kvc0/nomad3_mods/cad/bed_model.step

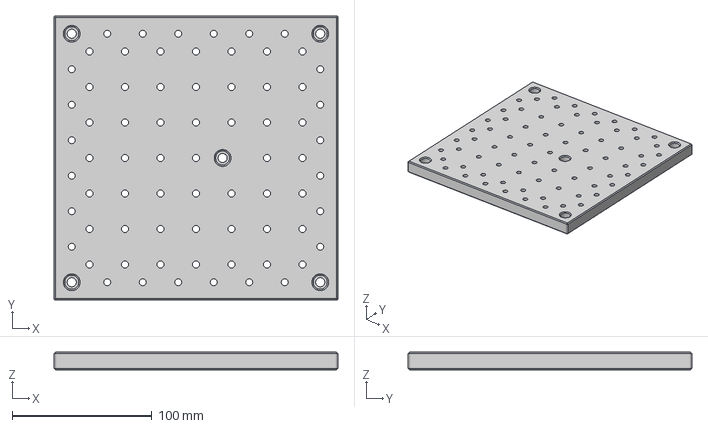
[picture p4: CAD file, 2021-01-08]
cad/bed_model.step
203.2 x 203.2 x 12.7 mm
