kvc0/nomad3_mods/models/air_blast_lock.stl

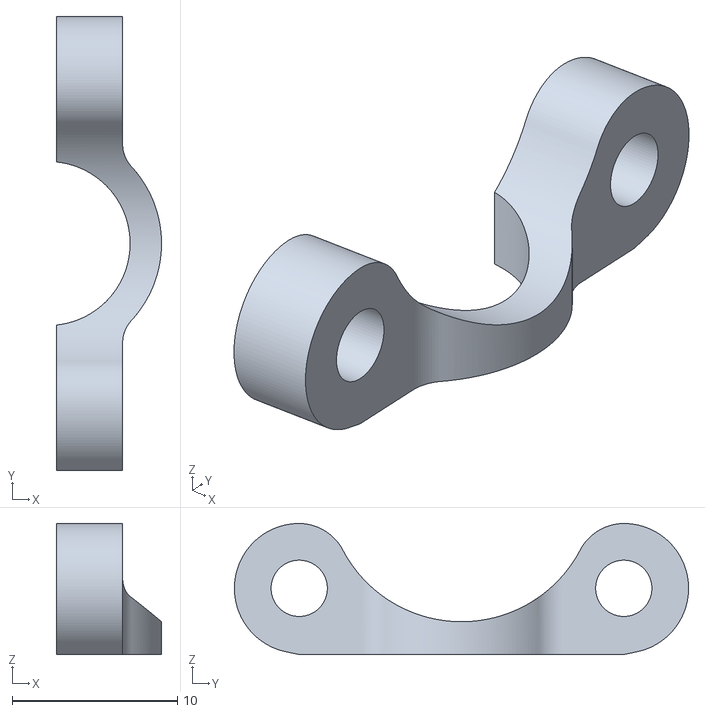
[picture p5: CAD file, 2021-01-07]
models/air_blast_lock.stl
6.35 x 27.4 x 7.92
