kvc0/nomad3_mods/models/air_blast_bracket.stl

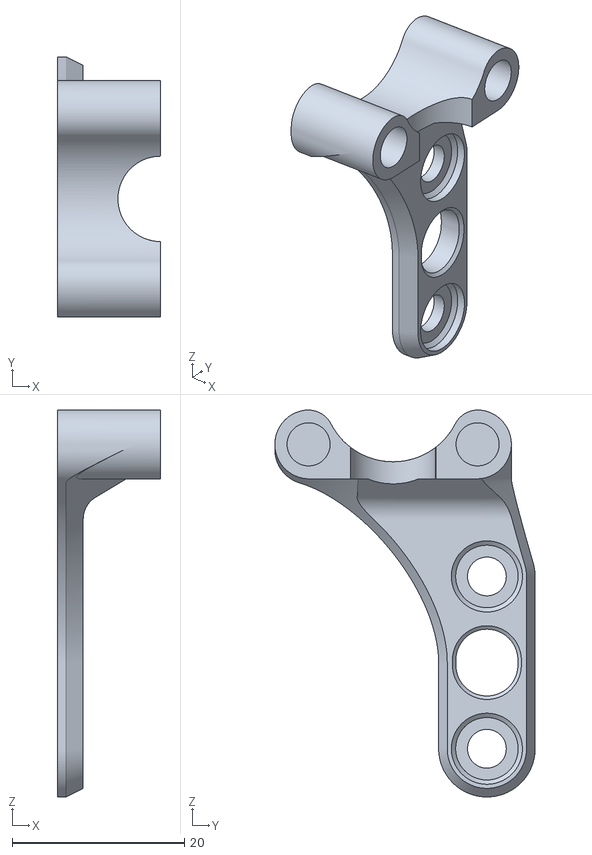
[picture p6: CAD file, 2021-01-07]
models/air_blast_bracket.stl
12.0 x 30.2 x 44.9
