kvc0/nomad3_mods/(list of files, cad)

Other CAD files:
cad/air_blast_bracket.f3d
cad/bed_model.f3d
