kvc0/nomad3_mods/(commit log)

2021-01-07 Add air blast mod
    [air_blast_bracket.f3d, air_blast_bracket.stl, air_blast_lock.stl]
2021-01-08 Add carbide3d threaded bed for nomad CAD models
    for setting up milling jobs knowing exactly where the bolt holes are.
    [bed_model.f3d, bed_model.step]
